BalzGuenat/SatGazer/gear.stl

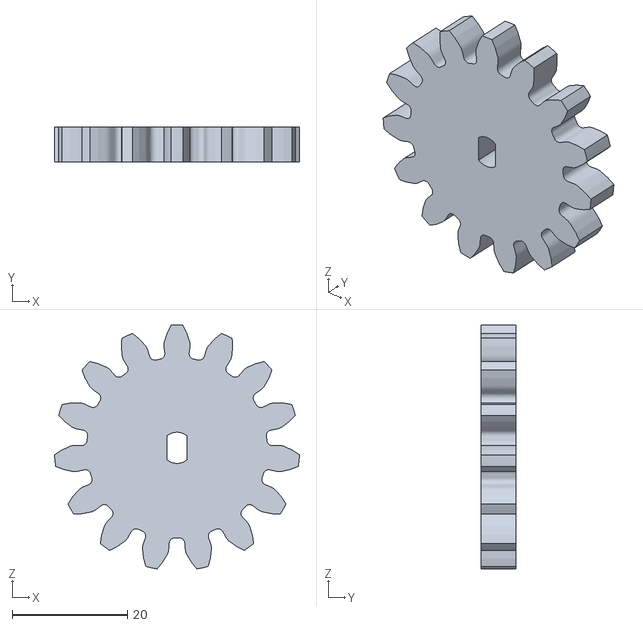
[picture p1: CAD file, 2019-05-05]
gear.stl
42.4 x 6.00 x 42.2
