BalzGuenat/SatGazer/base_plate.stl

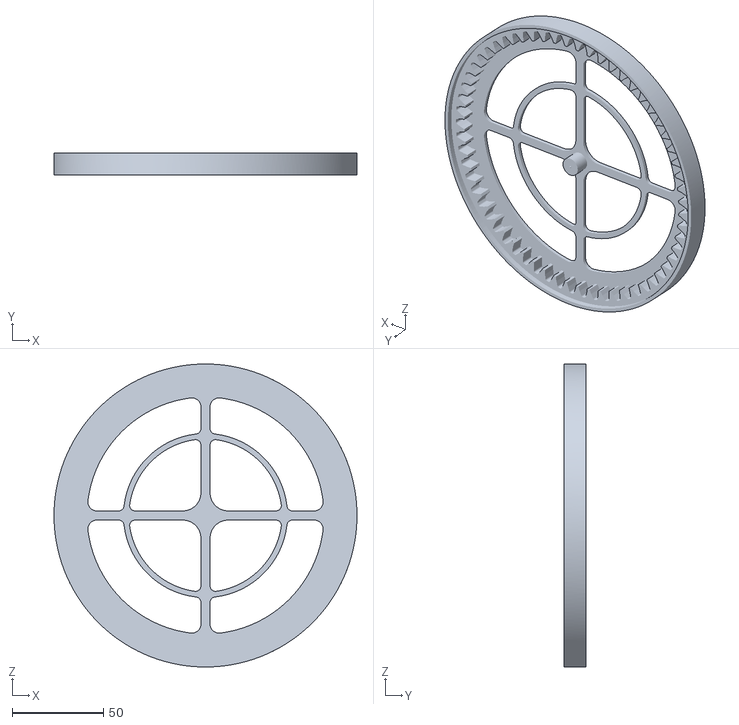
[picture p2: CAD file, 2019-05-05]
base_plate.stl
166.2 x 12.0 x 166.2
