BalzGuenat/SatGazer/arrow.stl

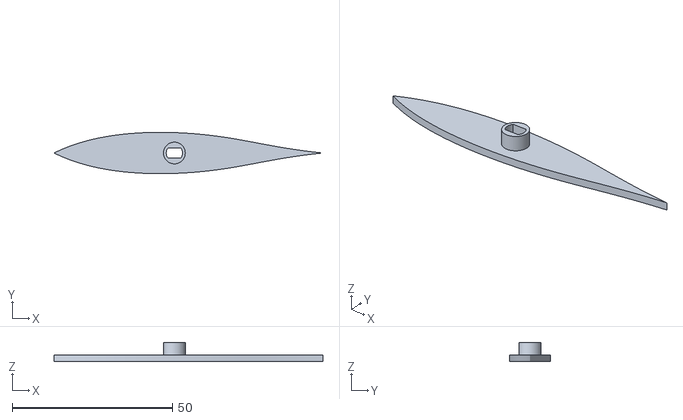
[picture p3: CAD file, 2019-05-05]
arrow.stl
84.0 x 12.9 x 6.00
