BalzGuenat/SatGazer/top_plate.stl

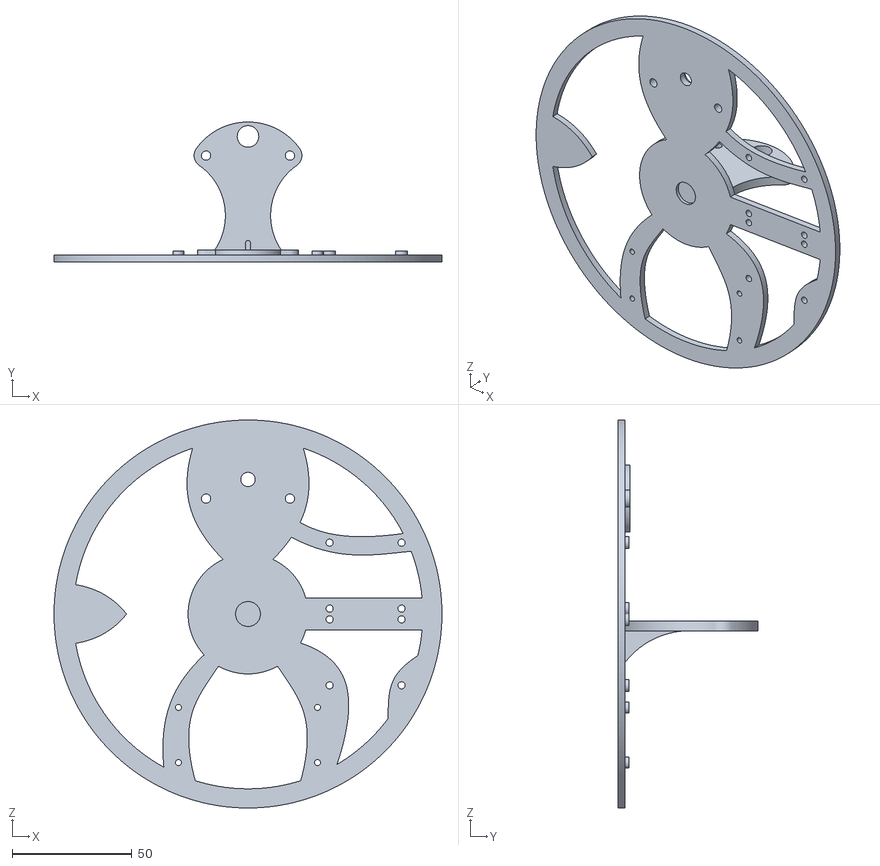
[picture p4: CAD file, 2019-05-05]
top_plate.stl
161.9 x 58.4 x 161.9
