BalzGuenat/SatGazer/(commit log)

2019-04-01 add motor control code
2019-04-06 add unipolar motor
2019-04-06 add calibrate and coast buttons, names for motors, smoother update and shutdown
2019-04-06 coast for power saving, accept connections from anywhere
2019-04-06 add driver controls to gui
2019-05-05 changes for first full prototype
2019-05-05 fix motor direction
2019-05-05 add STLs
    [arrow.stl, base_plate.stl, gear.stl, top_plate.stl]
